phuongtung0801/P2G_OriginalFW/Hardware/ReadMe.txt

===============================================================================
Folder Contents
===============================================================================

- Altium files
  *  Complete PCB project of the demo board

- Production data
  *  BOM list, PCB layer stack, Gerber data etc. for production of the demo boards

- Schematics
  *  Schematics of the demo board

     Note: In order to open the 3D PDF schmatics using Adobe Reader, please proceed as follows:
           - Click Options -> Trust this document always
           - Click Options -> Enable JavaScript for this document always
