phuongtung0801/P2G_OriginalFW/Hardware/Production data/P2G_BOM_V1.2.xlsx

Board: |  | Position2Go V1.2
Date: |  | 2020-02-12
QTY | Fitted / DNP | Designator | Value | Footprint / Part Number / Manufacturer
1 | Fitted | U5 | BGT24-MTR12 | SMD VQFN32 Infineon
1 | Fitted | U32 | XMC4200-Q48K256 (ABXUMA1) --MSL 3--- | SMD VQFN48-EP (PG-VQFN48-53) Infineon
1 | Fitted | U1 | XMC4700E196(K)2048AA -MSL3- | SMD LFBGA196 0,8mm Infineon
1 | Fitted | U31 | IFX54211MBV33 | SMD SCT-595-5 Infineon
1 | Fitted | Q1 | IRLHS2242TR*PbF | SMD PQFN6-ExposedPad Infineon
3 | Fitted | D2, D3, D7 | Diode BAS3010A-03W Marking: 4/blue | SMD SOD323 Infineon
2 | Fitted | TS1, TS2 | ESD-Diode ESD5V3U2U-03LRH | SMD TSLP-3-7 Infineon
1 | Fitted | Platine | PCB RADV3_V1.1
4 | Fitted | C53, C62, C71, C79 | Capacitor 1nF 50V 1206 COG 5% | SMD 1206
8 | Fitted | C49, C52, C60, C61, C67, C70, C77, C78 | Capacitor 2.7nF 50V 1206 COG 5% | SMD 1206
4 | Fitted | L1, L2, L3, L4 | Ferritperle BLM18PG600SN1 60R/0,5A | SMD 0603 Murata
1 | Fitted | C23 | Kerko 33nF ±10% 50V X7R | SMD 0402
8 | Fitted | C47, C55, C56, C63, C66, C72, C73, C80 | KerKo 6.8pF ±0,5% 25V COG/NPO | SMD 0201 GRM0335C1E6R8DA01D Murata
12 | Fitted | C12, C13, C18, C19, C36, C45, C46, C54, C64, C65, C82, C86 | KerKo 10µF 10V X5R ±20% | SMD 0402 CL05A106MP5NU Samsung
27 | Fitted | C1, C2, C3, C4, C5, C6, C10, C11, C21, C24, C25, C31, C33, C34, C35, C41, C48, C50, C51, C57, C58, C59, C68, C69, C74, C75, C76 | KerKo 100nF ±10% 35V X5R | SMD 0201 Murata GRM033R6YA104K
8 | Fitted | C15, C81, C83, C87, C88, C89, C91, C92 | KerKo 100nF ±5% 16V X7R | SMD 0402 GRM155R71C104JA88 Murata
2 | Fitted | C32, C43 | KerKo 10nF ±10% 10V X5R | SMD 0201 C0603X5R1A103K030 TDK
3 | Fitted | C27, C29, C42 | KerKo 10pF ±1% 50V NPO/COG | SMD 0201 GRM0335C1H100FA01 Murata
2 | Fitted | C37, C38 | KerKo 150pF ±5% 25V NPO/COG | SMD 0201
2 | Fitted | C84, C85 | KerKo 15pF ±1% 50V NPO/COG | SMD 0402 GRM1555C1H150FA01 Murata
2 | Fitted | C98, C99 | KerKo 1nF ±5% 50V COG/NPO | SMD 0402 GRM1555C1H102JA01D Murata
11 | Fitted | C14, C16, C17, C28, C30, C39, C40, C93, C94, C95, C96 | KerKo 1nF ±10% 25V X7R | SMD 0201 CL03B102KA3NNNC Samsung
1 | Fitted | C97 | KerKo 1pF ±0,1% 25V NPO/COG | SMD 0201 250R05L1R0BV4T JOHANSON TECH
1 | Fitted | C22 | KerKo 2.2nF ±5% 50V COG (NPO) | SMD 0402 CC0402JRX7R9BB222
2 | Fitted | C9, C90 | KerKo 4µ7F ±10% 10V X5R | SMD 0402 C1005X5R1A475K050 TDK
5 | Fitted | D1, D4, D5, D6, D8 | LED Grün 10mA 2,0V --MSL2-- | SMD 0201 KPG-0603CGC-TT Kingbright
1 | Fitted | U7 | LMX2491RTW* -40°C/+85°C --MSL3-- | SMD WQFN24-Exposed Pad TI
3 | Fitted | U3, U4, U28 | LP5907UV*-3.3/NOPB Marking: D | SMD DSBGA_4 (YKE) TI
1 | Fitted | U23 | LP5912-3.3DRV* Marking: 12-F | SMD WSON6 (DRV) TI
2 | Fitted | J3, J4 | Mikro USB 2.0 Type AB Male gewink. | SMD ZX62-AB-5PA(31) Hirose
1 | Fitted | J6 | Mikro-Stiftleiste 2x5polig +Verpolschutz | SMD FTSH-105-01-L-DV-K 1,27mm SAMTEC
3 | Fitted | U24, U26, U27 | OPA2376AIYZD_ | SMD DSBGA8 0,5mm 2x1x0,63mm TI
4 | Fitted | U25, U29, U30, U33 | PGA112AIDGS* (Mark= P112) -MSL2- | SMD VSSOP10(DGS) TI
1 | Fitted | U40 | Quarz 12MHz ±50ppm ±15ppm 8pF NDK | SMD NX3225SA-12.000M-STD-CRS-2
1 | Fitted | U21 | Quarzosz. 40,000MHz ±50ppm 15pF 3V3 | SMD KC3225A40.0000C3GE00 AVX/KYOCERA
1 | Fitted | J7 | Stiftleiste 1x5polig gerade FISCHER | THT RM2,54 SL1 025=Stift 5,8mm vergold.
24 | Fitted | R21, R28, R47, R49, R52, R53, R56, R64, R66, R67, R74, R75, R82, R83, R110, R111, R112, R113, R125; R126, R127, R128, R129, R130 | Wid. 0R0 (Jumper) 0,05W max. 50mR | SMD 0201
1 | Fitted | R90 | Wid. 0R0 (Jumper) ±5% 0,063W max.50mR | SMD 0402
4 | Fitted | R73, R120, R121, R122 | WID. 0R00 ±1% 0,1/0,125W ±50ppm Jumper | SMD 0603 MCT06030Z0000ZP Vishay
19 | Fitted | R11, R12, R13, R30, R33, R37, R44, R60, R61, R63, R103-109, R119, R132 | Wid. 100R ±1% 0,05W ±200ppm | SMD 0201
2 | Fitted | R133, R_MOD | Wid. 100R ±1% 0,063W TK100 | SMD 0402
20 | Fitted | R3, R6, R50, R54, R55, R57, R58, R68, R69, R71, R76, R78. R80, R85, R86, R88, R116, R118, R131, R135 | Wid. 10K0 ±1% 0,05W ±100 ppm/°C | SMD 0201
2 | Fitted | R98, R102 | Wid. 10K0 ±1% 0,063W TK100 | SMD 0402
1 | Fitted | R38 | Wid. 10R0 ±1% 0,05W TK200 | SMD 0201
1 | Fitted | R25 | Wid. 120R ±1% 0,063W TK100 | SMD 0402
8 | Fitted | R51, R62, R65, R72, R77, R81, R84, R89 | Wid. 150K0 ±1% 0,05W ±200 ppm/°C | SMD 0201
2 | Fitted | R45, R46 | Wid. 150R ±1% 0,05W ±100ppm/°C | SMD 0201
10 | Fitted | R_1, R10, R16, R59, R70, R79, R87, R92, R93, R114 | Wid. 1K0 ±1% 0,05W ±100 ppm/°C | SMD 0201
4 | Fitted | R17, R18, R123, R124 | Wid. 1K50 ±1% 0,05W ±200ppm/ °C | SMD 0201
1 | Fitted | R97 | Wid. 1M0 ±1% 0,063W TK100 | SMD 0402
1 | Fitted | R19 | Wid. 1M0 ±1% 0,05W ±200 ppm/°C | SMD 0201
6 | Fitted | R22, R26, R27, R39, R40, R41 | Wid. 1R0 ±1% 0,05W TK200 | SMD 0201
1 | Fitted | R_2 | Wid. 2K0 ±1% 0,05W ±200 ppm/°C | SMD 0201
2 | Fitted | R_33, R_34 | Wid. 33R0 ±1% 0,05W ±200ppm/°C | SMD 0201
4 | Fitted | R8, R9, R100, R101 | Wid. 33R0 ±1% 0,063W TK100 | SMD 0402
1 | Fitted | R96 | Wid. 4K70 ±1% 0,063W TK100 | SMD 0402
3 | Fitted | R91, R99, R134 | Wid. 510R ±1% 0,063W TK100 | SMD 0402
2 | Fitted | R32, R43 | Wid. 51R0 ±1% 0,05W ±200ppm | SMD 0201
1 | Fitted | R23 | Wid. 820R ±5% 0,063W | SMD 0402
not fitted
1 | DNP | C20 | KerKo 100nF ±10% 35V X5R | SMD 0201 Murata GRM033R6YA104K
1 | DNP | C26 | KerKo 100nF ±10% 35V X5R | SMD 0201 Murata GRM033R6YA104K
1 | DNP | J1 | Stiftleiste 1x14polig gerade FISCHER | THT RM2,54 SL1 025=Stift 5,8mm vergold.
1 | DNP | J2 | Stiftleiste 1x14polig gerade FISCHER | THT RM2,54 SL1 025=Stift 5,8mm vergold.
1 | DNP | R24 | Wid. 100R ±1% 0,05W ±200ppm | SMD 0201
1 | DNP | R34 | Wid. 100R ±1% 0,05W ±200ppm | SMD 0201
1 | DNP | R20 | Wid. 0R0 (Jumper) 0,05W max. 50mR | SMD 0201
1 | DNP | R29 | Wid. 0R0 (Jumper) 0,05W max. 50mR | SMD 0201
1 | DNP | R31 | Wid. 0R0 (Jumper) 0,05W max. 50mR | SMD 0201
1 | DNP | R35 | Wid. 0R0 (Jumper) 0,05W max. 50mR | SMD 0201
1 | DNP | U6 | TS5A23166YZT_ Marking: JM7~JMN | SMD DSBGA8 0,5mm TI
1 | DNP | U20 | TS5A23166YZT_ Marking: JM7~JMN | SMD DSBGA8 0,5mm TI
1 | DNP | R115 | Wid. 0R0 (Jumper) 0,05W max. 50mR | SMD 0201
