phuongtung0801/P2G_OriginalFW/Hardware/Production data/P2G_PCB_Assembly_plan_BOTTOM_V1.2.pdf

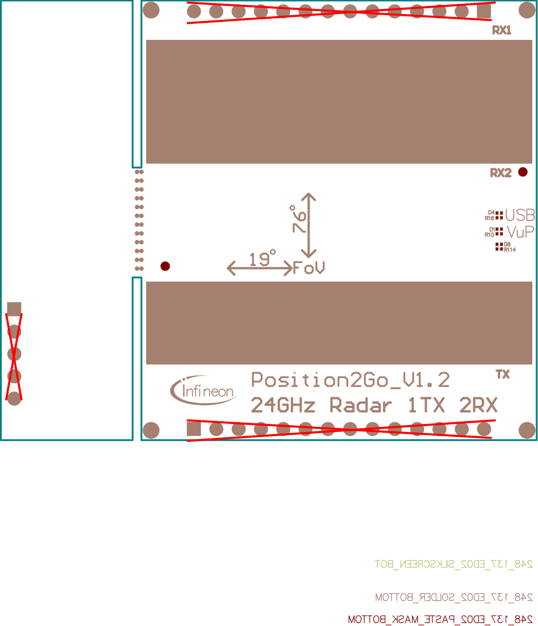
[picture p1: page 1]
