phuongtung0801/P2G_OriginalFW/ReleaseNotes.txt

===============================================================================
Change History                               
===============================================================================

2020-07-09:
    -  Release version 1.0.3
	* Updated 24GHz_Radar_Tools_and_Development_Environment_User_Manual document (v1.1)
	* Removed FFT scaling based on samples per chirp. Updated the FFT window without any scaling in it. 
	* Fixed timeout issue with Host C ComLib for longer data recordings 
	* Fixed ADC sampling rate to prevent wrong numbers 
	* Matlab example updated
	* Update on Matlab files due to updated Binary format of RadarGUI V1.5.1
    * Update on schematics
    * Updated P2G_Application_Note_AN553 document (v1.3)

2019-09-16:
    -  Release version 1.0.2
        * Updated P2G_Application_Note_AN553 document (v1.2)
        * Updated P2G_Matlab_Radar_System_API document (v1.2)
        * Fixed Speed estimation formula in ParseRawDataFile Matlab example
        * Changed num_Rx_antennas from physical to used number of receive antennas in ParseRawDataFile Matlab example
        * Fixed compare_float() function under tracking.c file
        * Fixed maximum distance in peak_search_max_idx under range_doppler.c file
        * Fixed typo LAN gain, to LNA gain under BGT driver defines and enum
        * Fixed implicit conversion warnings

2019-06-14:
    -  Release version 1.0.1
        * Renamed DAVE™ projects and generated .hex files by removing 'Radar_' prefix
        * Renamed 'Debug' Configuration to 'Build' Configuration, and removed 'Release' Configuration
        * Changed compiler optimization level from -O0 (no optimization) to -O3 (full optimization)
        * Removed Adaptive Threshold and Range Threshold Type Settings from FW, Radar GUI and ComLib Interface
        * Fixed bug in BGT output TX power (in dBm) read out support in Radar GUI
        * Corrected BSP driver base config address for BGT12MTR12
        * Fixed bug in Target ID listing read out support in Radar GUI
        * Updated Sampling frequency for FMCW (FMCW_SAMPLING_FREQ_HZ) from config.h file, to be configurable based CHIRP_TIME_USEC and SAMPLES_PER_CHIRP
        * Added ALGO_PROCESS_TIME_USEC parameter referring to the minimum time used to process raw data from config.h file
        * Corrected Matlab API for "set pga gain" function
        * Added ParseRawDataFile example under ComLib_Matlab_Interface used to parse recorded raw data from Radar GUI
        * Added new 24GHz_Radar_Tools_and_Development_Environment_User_Manual document (v1.0)
        * Updated P2G_Application_Note_AN553 document (v1.1)
        * Updated P2G_Software_User_Manual document (v1.1)

2018-12-14:
    -  Initial version 1.0.0
        * Capability to detect and track the position of multiple targets (up to 5)
        * Capability to detect distance of multiple targets
        * Capability to detect motion, speed and direction of movement (approaching or retreating)
        * Operates in harsh environments and detects through non-metallic materials
        * Small form-factor (5.0 × 4.5 cm)
        * 24GHz ISM band module that can be used as a development kit size or mounted as a daughter board in a system
        * Integrated multiple element patch antenna (1 x 6)
        * Programming API for communication with the chip from a PC (C & Matlab)

================================================================================
Known Limitations
================================================================================
    -  Tracking limitations:
        * Multiple targets lying in the same range bin cannot be resolved with the given antenna setup (physical limitation)
        * The tracking algorithm is based on a constant velocity model, tracking with speed higher than 4 km/h may result in splitting targets
        * The implemented solution is using a simple α-β tracking algorithm which has its limitations when tracking multiple moving targets which cross paths
        * The tracking algorithm is designed for outdoor scenarios, due to multi-path reflections and limited signal processing the user may experience so 
	* The accuracy of speed measurements is limited by the number of chirps per frame (16), a higher number of chirps will result in better performance
    -  After removing the debugger breakout board there is no programming/debug functionality available anymore
