phuongtung0801/P2G_OriginalFW/Hardware/Schematics/P2G_Schematics_V1.3.PDF

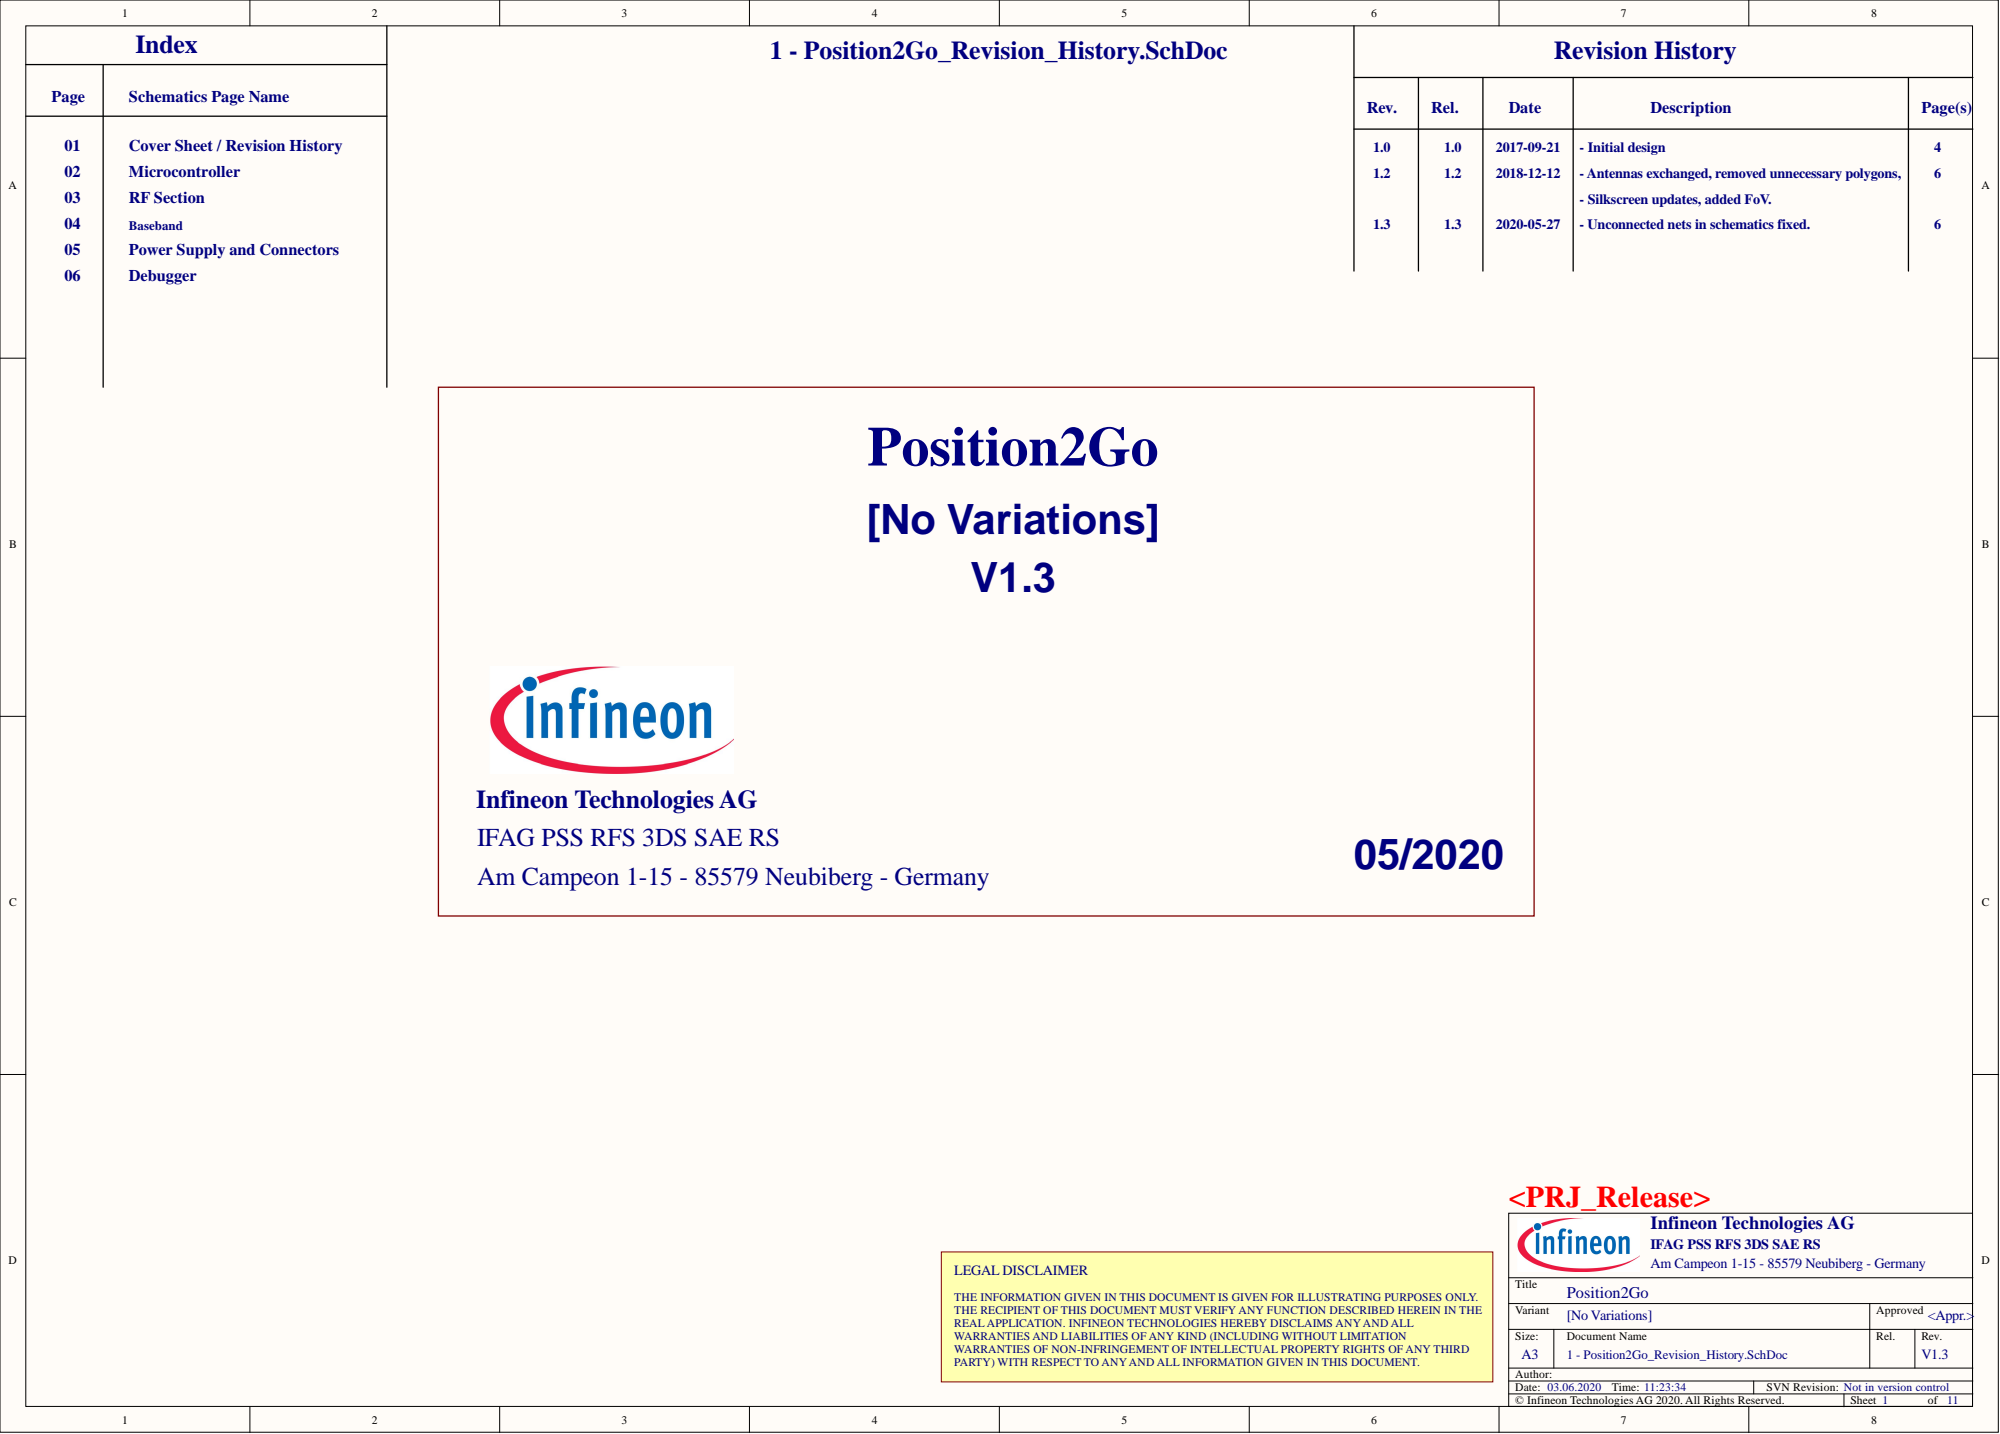
[picture p4: page 1]

Cover Sheet / Revision History
Microcontroller
RF Section

- Silkscreen updates, added FoV.

Baseband
Power Supply and Connectors
Debugger

Infineon Technologies AG
IFAG PSS RFS 3DS SAE RS
Am Campeon 1-15 - 85579 Neubiberg - Germany

THE INFORMATION GIVEN IN THIS DOCUMENT IS GIVEN FOR ILLUSTRATING PURPOSES ONLY.
THE RECIPIENT OF THIS DOCUMENT MUST VERIFY ANY FUNCTION DESCRIBED HEREIN IN THE
REAL APPLICATION. INFINEON TECHNOLOGIES HEREBY DISCLAIMS ANY AND ALL
WARRANTIES AND LIABILITIES OF ANY KIND (INCLUDING WITHOUT LIMITATION
WARRANTIES OF NON-INFRINGEMENT OF INTELLECTUAL PROPERTY RIGHTS OF ANY THIRD
PARTY) WITH RESPECT TO ANY AND ALL INFORMATION GIVEN IN THIS DOCUMENT.

Variant [No Variations] | Approved <Appr.>

Size: A3 | Document Name 1 - Position2Go_Revision_History.SchDoc | Rel. | Rev. V1.3

Date: 03.06.2020 Time: 11:23:34 | SVN Revision: Not in version control
© Infineon Technologies AG 2020. All Rights Reserved. | Sheet 1 of 11

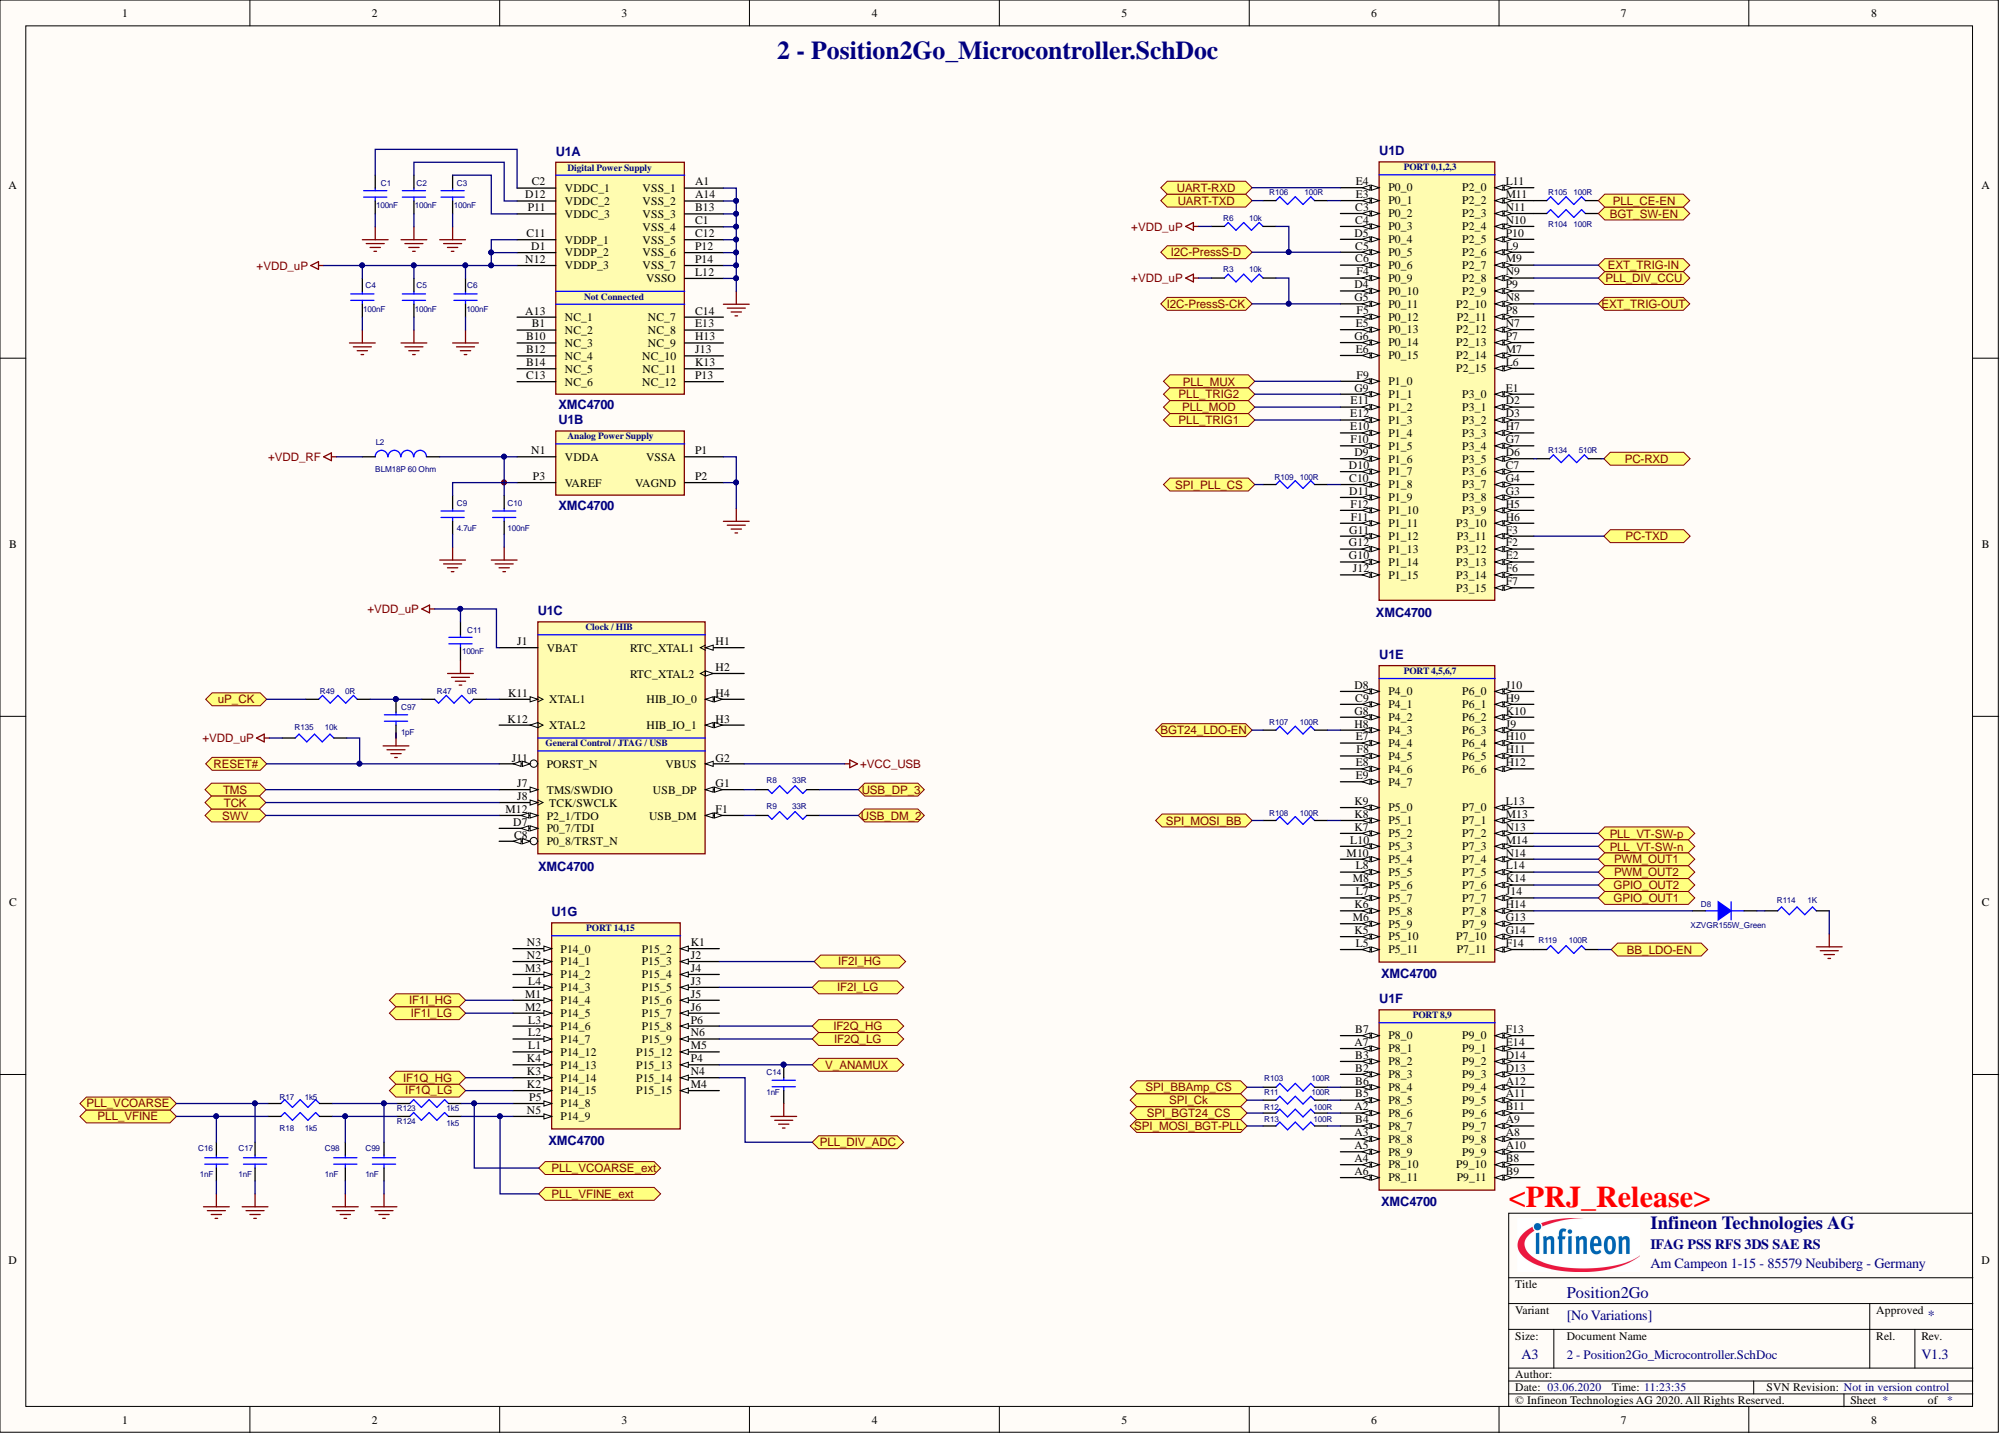
[picture p5: page 2]

General Control / JTAG / USB

Infineon Technologies AG
IFAG PSS RFS 3DS SAE RS
Am Campeon 1-15 - 85579 Neubiberg - Germany

[No Variations] | Approved *

2 - Position2Go_Microcontroller.SchDoc

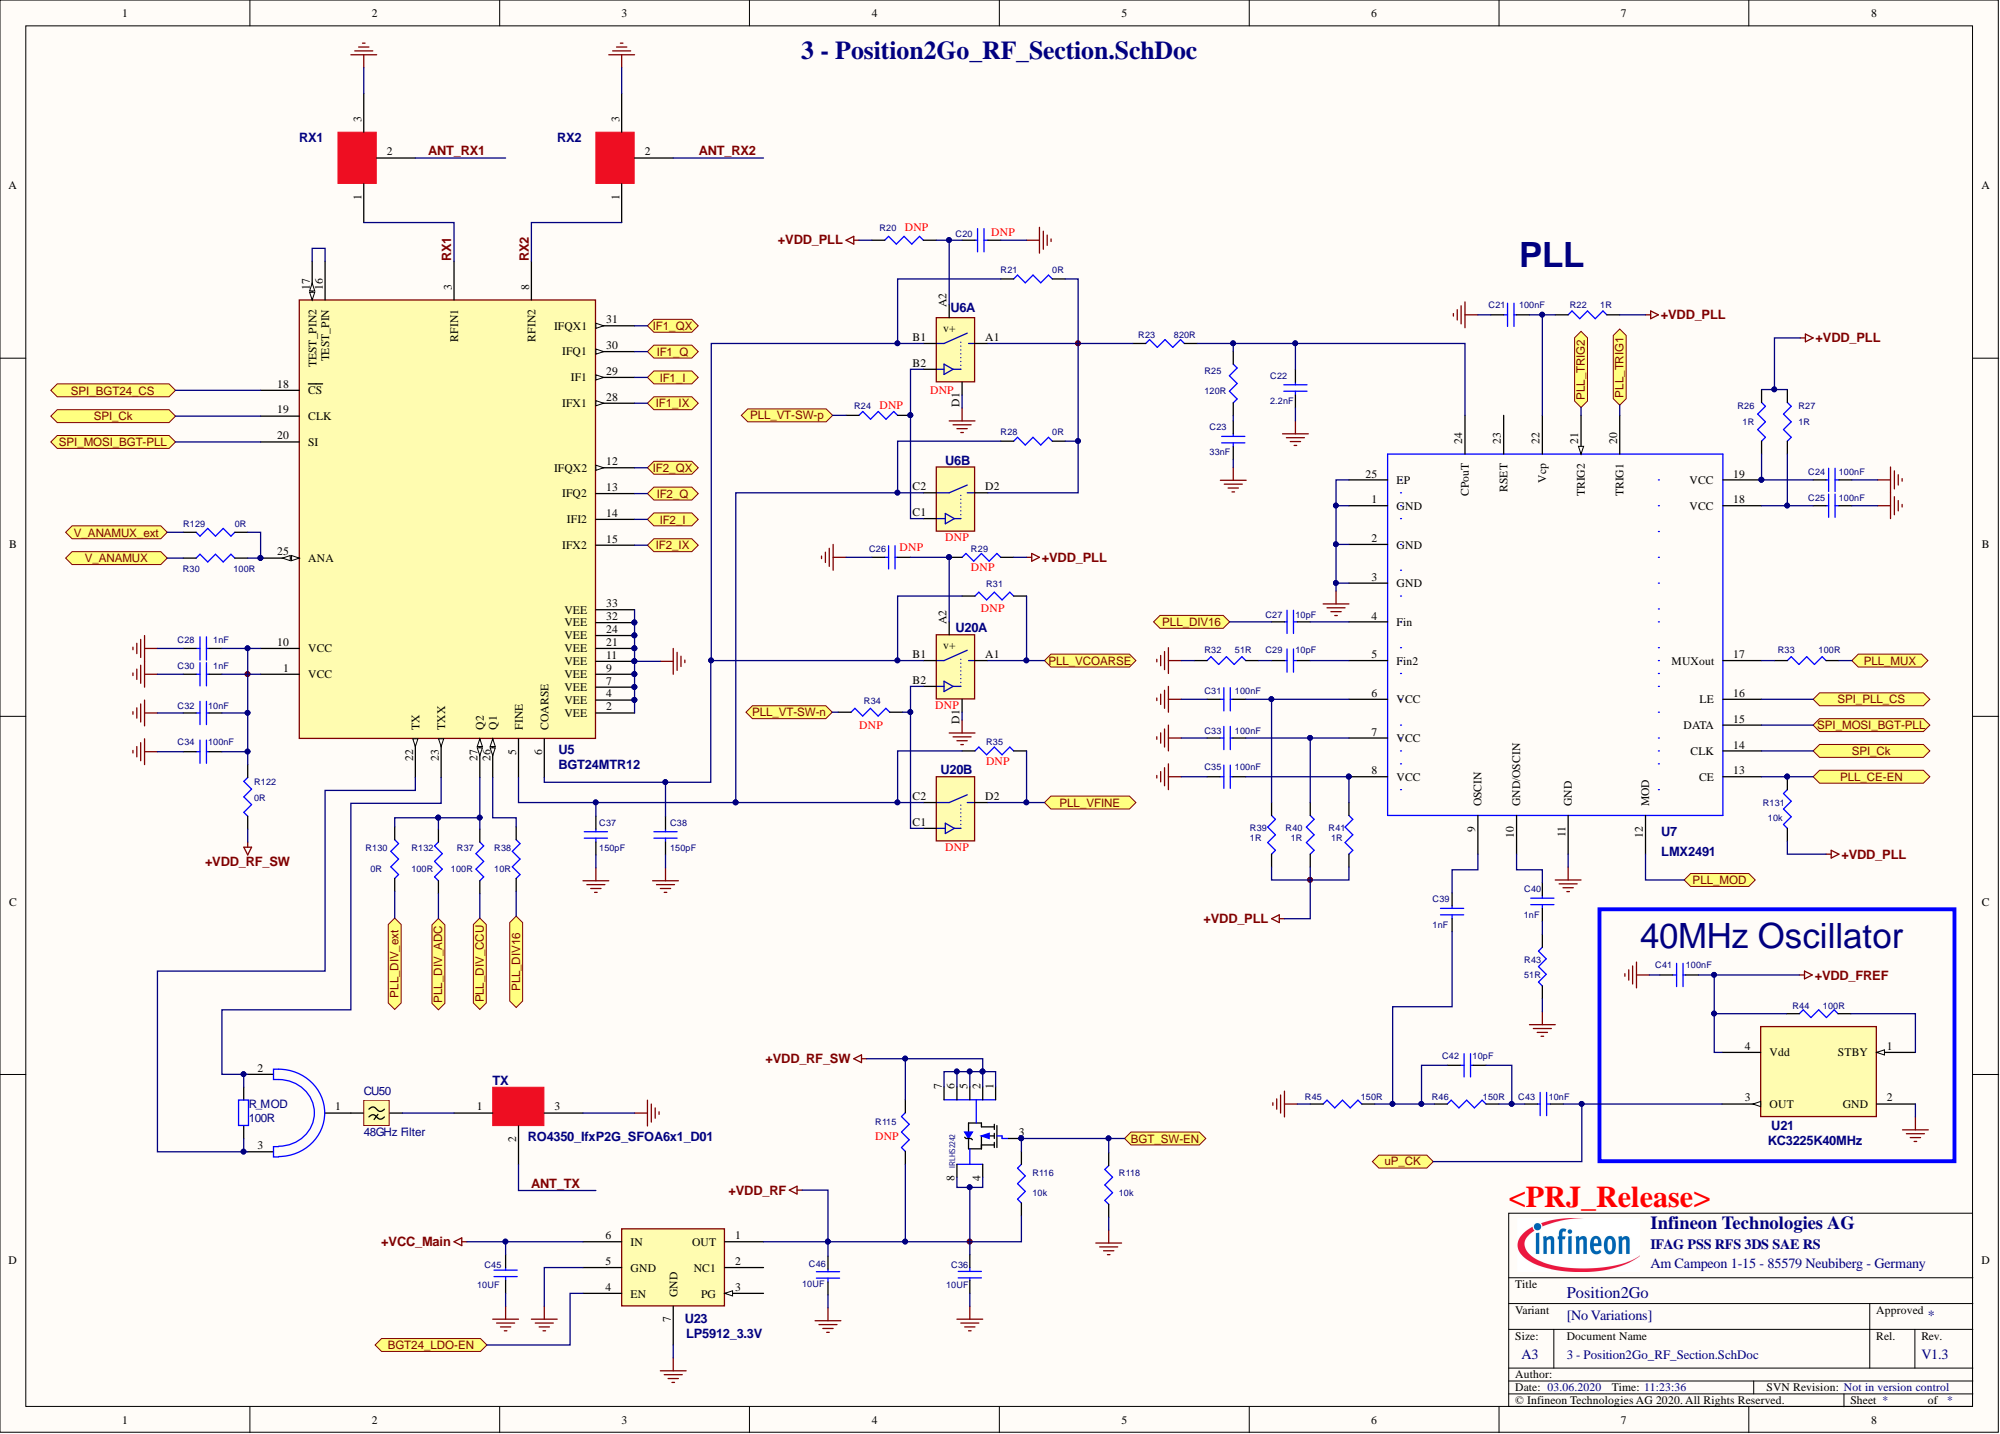
[picture p6: page 3]

VCC 7

Infineon Technologies AG
IFAG PSS RFS 3DS SAE RS
Am Campeon 1-15 - 85579 Neubiberg - Germany

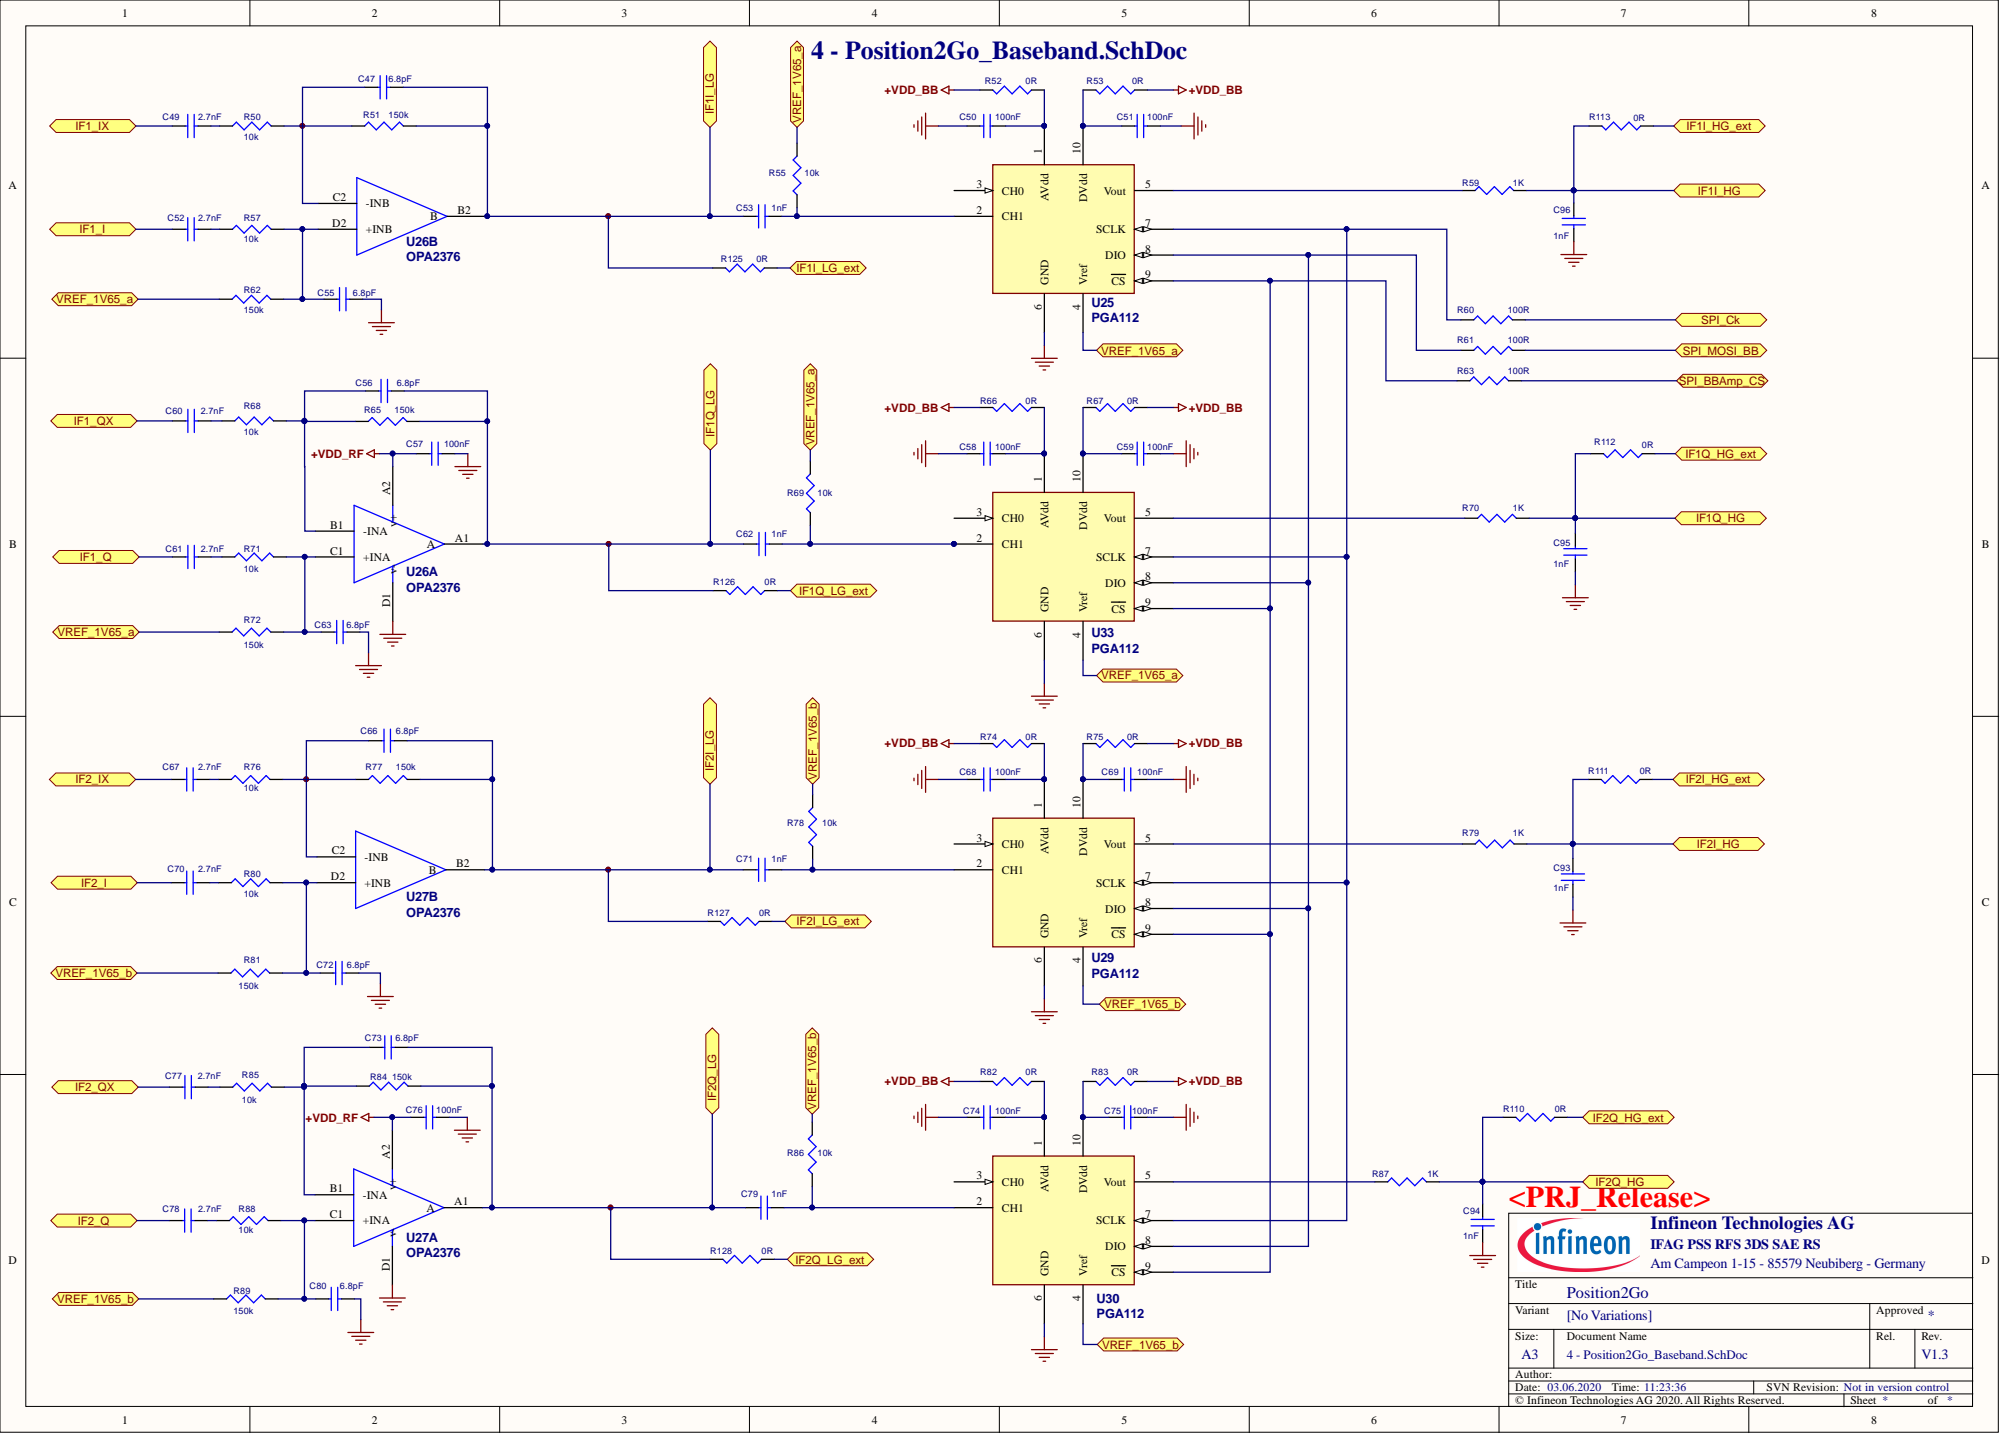
[picture p7: page 4]

Varian t [N o V ariatio ns] | A p pro ved *

Size: A | D ocumen t Name 4 -Pos i t ion2Go_Ba s eband. S chDoc | Rel . | Rev . 1.3

Date: 3.0 6.2 T ime: : : | SV N Rev i s i o n : N o t i n vers i o n co n tro l
© Infi neo n Tech n o l o g ies A G 2 0. A l l Ri g h t s Reserved . | Sheet * o f *

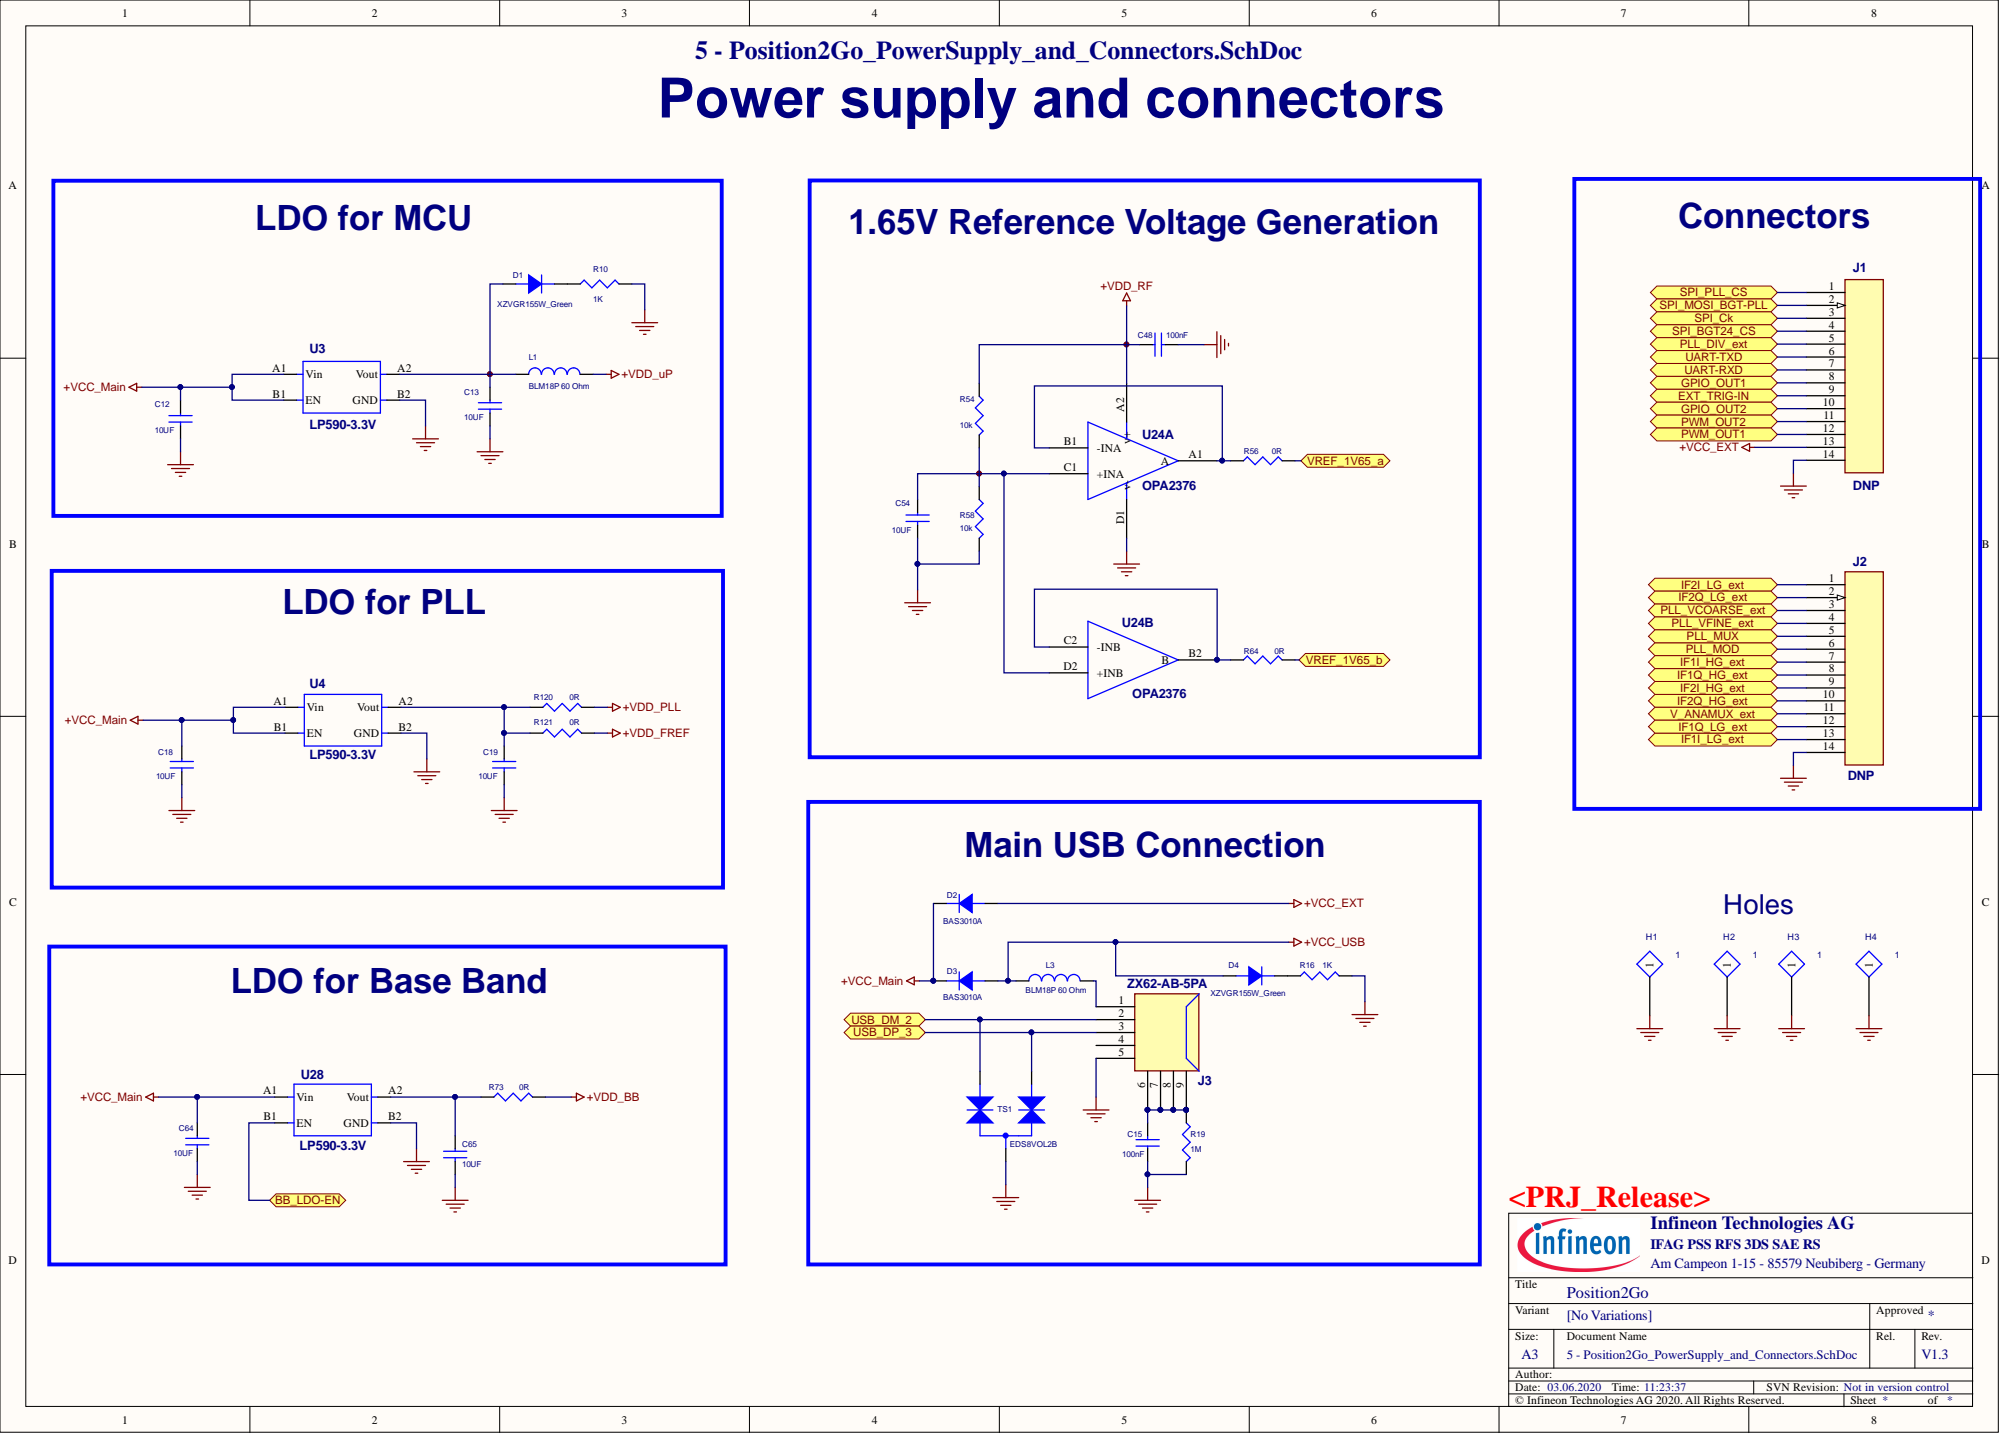
[picture p8: page 5]

Power supply and connectors

LDO for Base Band

Varian t [N o V ariatio ns] | A p pro ved *

Size: A | D ocumen t Name 5 -Pos i t ion2Go_Pow erSupply_and_Conne c tors . S chDoc | Rel . | Rev . 1.3

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

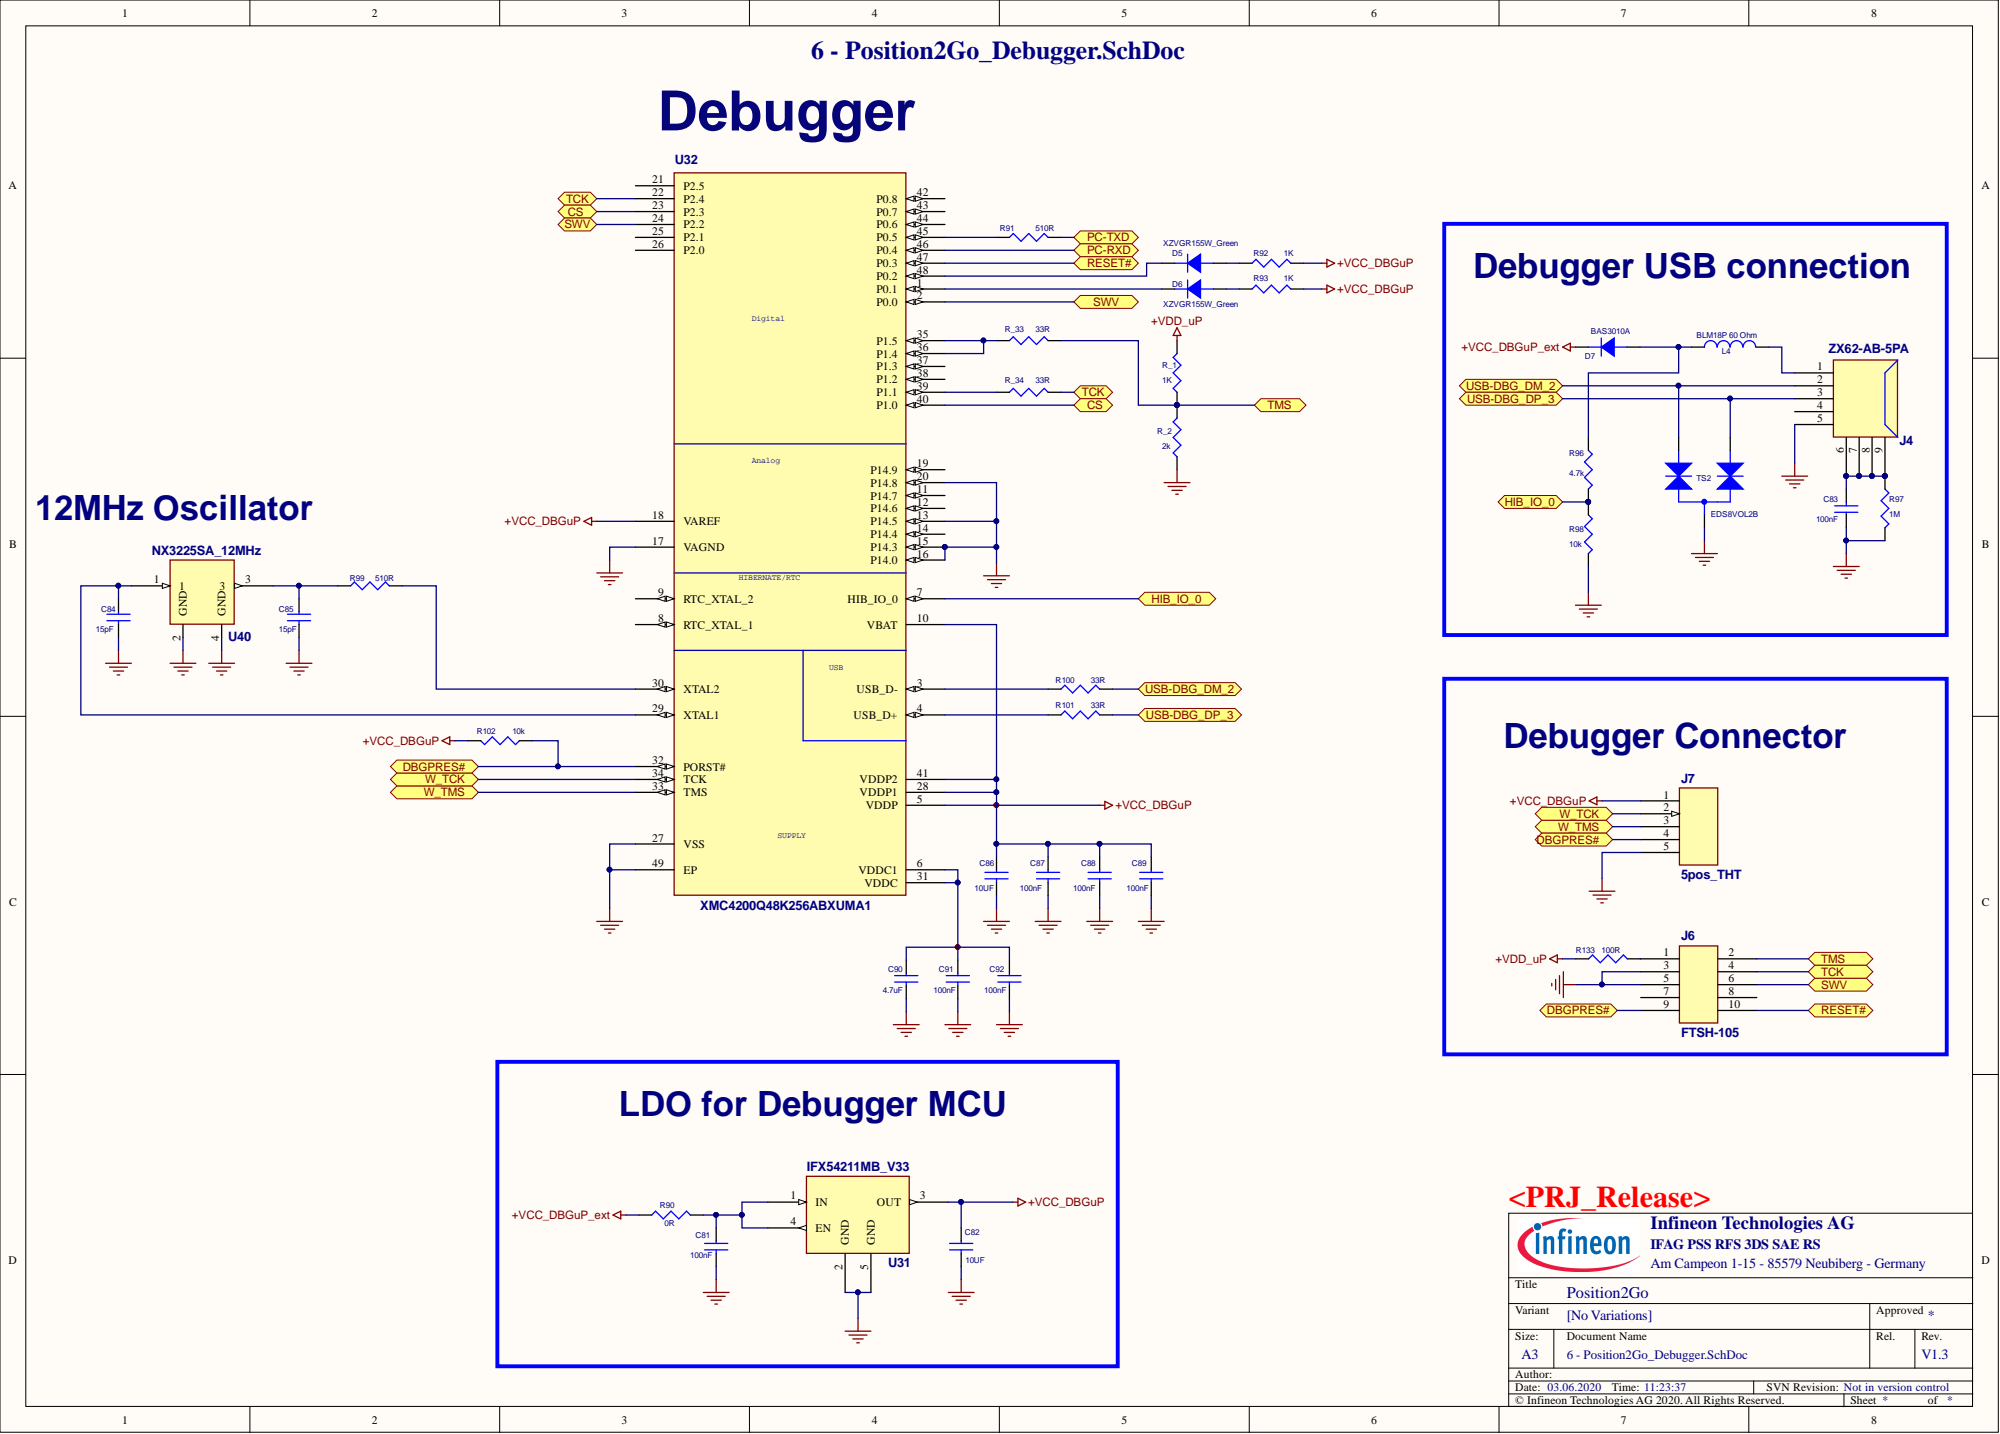
[picture p9: page 6]

LDO for Debugger MCU

Infineon Technologies AG
IFAG PSS RFS 3DS SAE RS
Am Campeon 1-15 - 85579 Neubiberg - Germany
