phuongtung0801/P2G_OriginalFW/(list of files, drawings)

Other design files:
Hardware/Altium files/Position2Go_V1.3/1 - Position2Go_Revision_History.SchDoc
Hardware/Altium files/Position2Go_V1.3/2 - Position2Go_Microcontroller.SchDoc
Hardware/Altium files/Position2Go_V1.3/3 - Position2Go_RF_Section.SchDoc
Hardware/Altium files/Position2Go_V1.3/4 - Position2Go_Baseband.SchDoc
Hardware/Altium files/Position2Go_V1.3/5 - Position2Go_PowerSupply_and_Connectors.SchDoc
Hardware/Altium files/Position2Go_V1.3/6 - Position2Go_Debugger.SchDoc
Hardware/Altium files/Position2Go_V1.3/Position2Go_V1.3.PrjPcb
