phuongtung0801/P2G_OriginalFW/Firmware_Software/Communication Library/ComLib_C_Interface/extract_raw_data.c

/*
 ===================================================================================
 Name        : extract_raw_data.c
 Author      : Infineon Technologies
 Version     :
 Copyright   : 2014-2017, Infineon Technologies AG
 Description : Example of how to extract raw data using the C communication library
 ===================================================================================
 */

/*
 * Copyright (c) 2014-2017, Infineon Technologies AG
 * All rights reserved.
 *
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
 * Neither the name of the copyright holders nor the names of its contributors may be used to endorse or promote
 * products derived from this software without specific prior written permission.
 *
 * THIS SOFTWARE IS PROVIDED BY THE COPYRIGHT HOLDERS AND CONTRIBUTORS "AS IS" AND ANY EXPRESS OR IMPLIED WARRANTIES,
 * INCLUDING, BUT NOT LIMITED TO, THE IMPLIED WARRANTIES OF MERCHANTABILITY AND FITNESS FOR A PARTICULAR PURPOSE ARE
 * DISCLAIMED. IN NO EVENT SHALL THE COPYRIGHT HOLDER OR CONTRIBUTORS BE LIABLE  FOR ANY DIRECT, INDIRECT, INCIDENTAL,
 * SPECIAL, EXEMPLARY, OR CONSEQUENTIAL DAMAGES (INCLUDING, BUT NOT LIMITED TO, PROCUREMENT OF SUBSTITUTE GOODS OR
 * SERVICES; LOSS OF USE, DATA, OR PROFITS; OR BUSINESS INTERRUPTION) HOWEVER CAUSED AND ON ANY THEORY OF LIABILITY,
 * WHETHER IN CONTRACT, STRICT LIABILITY,OR TORT (INCLUDING NEGLIGENCE OR OTHERWISE) ARISING IN ANY WAY OUT OF THE USE
 * OF THIS SOFTWARE, EVEN IF ADVISED OF THE POSSIBILITY OF SUCH DAMAGE.
 */

#include <stdio.h>
#include <string.h>
#include "include/Protocol.h"
#include "include/ProcessDataHelper.h"
#include "include/COMPort.h"
#include "include/EndpointRadarBase.h"
// #include "include/EndpointTestData.h"

#define AUTOMATIC_DATA_FRAME_TRIGGER (1)		// define if automatic trigger is active or not

#define AUTOMATIC_DATA_TRIGER_TIME_US (150000)	// get ADC data each 1ms in automatic trigger mode


// called every time ep_radar_base_get_frame_data method is called to return measured time domain signals
void received_frame_data(void* context,
						int32_t protocol_handle,
		                uint8_t endpoint,
						const Frame_Info_t* frame_info)
{
	static uint64_t index = 0;
	printf("sample %d number counter: %d\n", index, frame_info->frame_number);
	index++;
	// Print the sampled data which can be found in frame_info->sample_data
	// for (uint32_t i = 0; i < frame_info->num_samples_per_chirp; i++)
	// {
	// 	printf("ADC sample %d: %f\n", i, frame_info->sample_data[i]);
	// }
}

int radar_auto_connect(void)
{
	int radar_handle = 0;
	int num_of_ports = 0;
	char comp_port_list[256];
	char* comport;
	const char *delim = ";";

	//----------------------------------------------------------------------------

	num_of_ports = com_get_port_list(comp_port_list, (size_t)256);

	if (num_of_ports == 0)
	{
		return -1;
	}
	else
	{
		comport = strtok(comp_port_list, delim);

		while (num_of_ports > 0)
		{
			num_of_ports--;

			// open COM port
			radar_handle = protocol_connect(comport);

			if (radar_handle >= 0)
			{
				break;
			}

			comport = strtok(NULL, delim);
		}

		return radar_handle;
	}

}

int main(void)
{
	int res = -1;
	int protocolHandle = 0;
	int endpointRadarBase = 0;

	// open COM port
	protocolHandle = radar_auto_connect();
	printf("Number of endpoint is: %d\n", protocol_get_num_endpoints(protocolHandle));
	// get endpoint ids
	if (protocolHandle >= 0)
	{
		for (int i = 1; i <= protocol_get_num_endpoints(protocolHandle); ++i) {
			// current endpoint is radar base endpoint
			if (ep_radar_base_is_compatible_endpoint(protocolHandle, i) == 0) {
				endpointRadarBase = i;
				printf("Endpoint Radar base: %d\n", endpointRadarBase);
				continue;
			}
		}
	}


	if (endpointRadarBase >= 0)
	{
		// register call back functions for adc data
		ep_radar_base_set_callback_data_frame(received_frame_data, NULL);

		// enable/disable automatic trigger
		if (AUTOMATIC_DATA_FRAME_TRIGGER)
		{
			res = ep_radar_base_set_automatic_frame_trigger(protocolHandle,
															endpointRadarBase,
															AUTOMATIC_DATA_TRIGER_TIME_US);
		}
		else
		{
			res = ep_radar_base_set_automatic_frame_trigger(protocolHandle,
															endpointRadarBase,
															0);
		}

		while (1)
		{
			// get raw data
			res = ep_radar_base_get_frame_data(protocolHandle,
											   endpointRadarBase,
											   1);
		}
	}

	return res;
}
